phongdz98/Encoder/final_altium_encoder_project/step 3d file/encoder.step

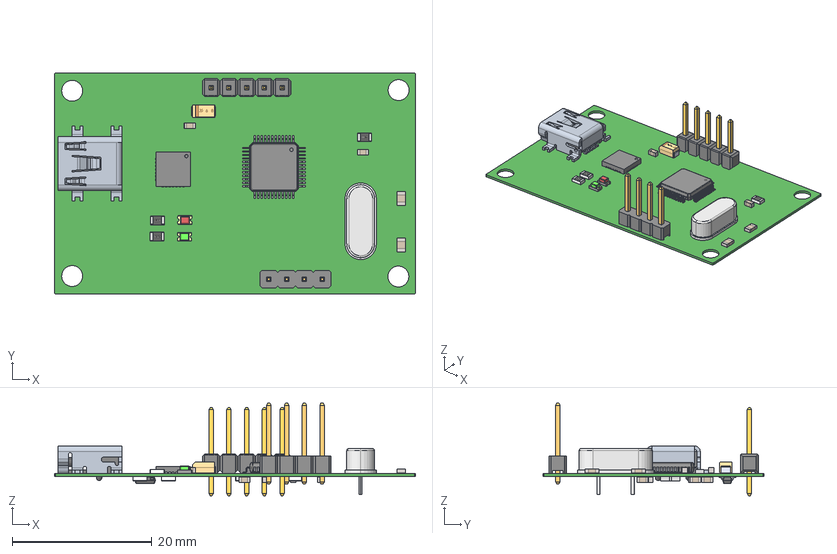
[picture p21: CAD file, 2021-06-27]
final_altium_encoder_project/step 3d file/encoder.step
51.7 x 31.6 x 13.3 mm
User_Library-SMD_RESISTOR-10805 x 7
CAP_TANT_3216-18
User_Library-USB_mini_B
Header_1x4
User_Library-User_Library-led_0805_GRE
User_Library-User_Library-led_0805_R
BODY_VBH48A
LEAD_VBH48A x 48
User_Library-sot143
User_Library-SMD_CAPACITOR0603 x 7
User_Library-SMD_CAPACITOR0805 x 2
