phongdz98/Encoder/final_altium_encoder_project/User Library-QFN28-0_5.STEP

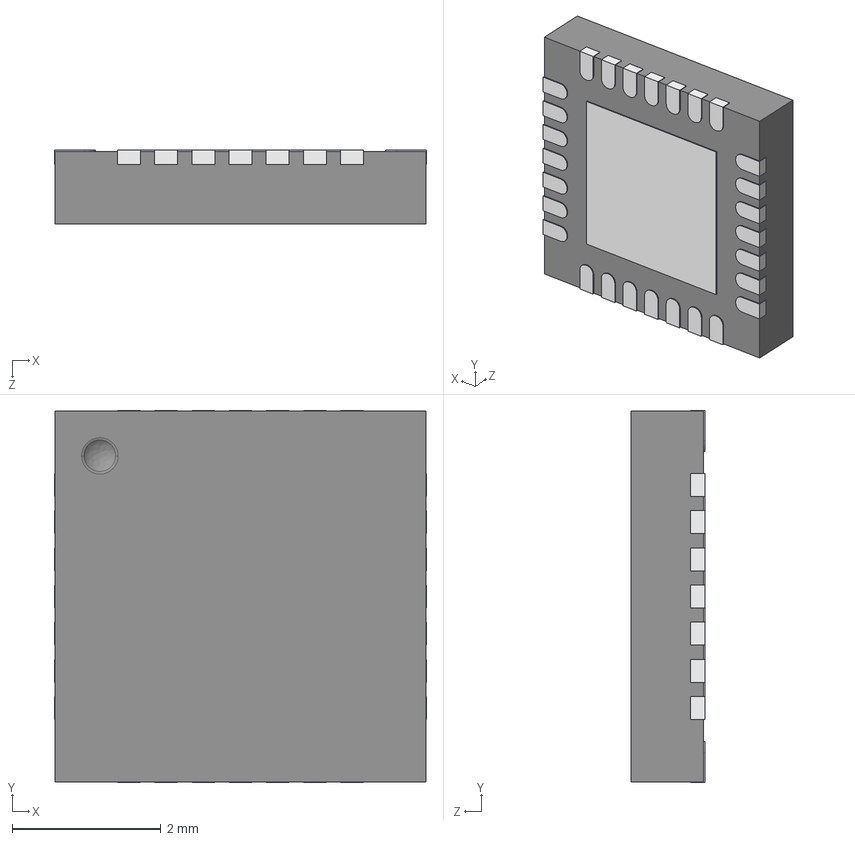
[picture p22: CAD file, 2021-06-27]
final_altium_encoder_project/User Library-QFN28-0_5.STEP
5.00 x 5.00 x 1.00 mm
