phongdz98/Encoder/(list of files, cad)

Other CAD files:
final_altium_encoder_project/step 3d file/BODY_VBH48A.ipt
final_altium_encoder_project/step 3d file/Board.iam
final_altium_encoder_project/step 3d file/C1.iam
final_altium_encoder_project/step 3d file/C10.iam
final_altium_encoder_project/step 3d file/C2.iam
final_altium_encoder_project/step 3d file/C3.iam
final_altium_encoder_project/step 3d file/C4.iam
final_altium_encoder_project/step 3d file/C5.iam
final_altium_encoder_project/step 3d file/C6.iam
final_altium_encoder_project/step 3d file/C7.iam
final_altium_encoder_project/step 3d file/C8.iam
final_altium_encoder_project/step 3d file/C9.iam
final_altium_encoder_project/step 3d file/CAP_TANT_3216-18.ipt
final_altium_encoder_project/step 3d file/DA1.iam
final_altium_encoder_project/step 3d file/DD1.iam
final_altium_encoder_project/step 3d file/DD2.iam
final_altium_encoder_project/step 3d file/Fillet.ipt
final_altium_encoder_project/step 3d file/Fillet002.ipt
final_altium_encoder_project/step 3d file/Fillet_1.ipt
final_altium_encoder_project/step 3d file/Fusion.ipt
final_altium_encoder_project/step 3d file/Fusion_1.ipt
final_altium_encoder_project/step 3d file/Header_1x4.ipt
final_altium_encoder_project/step 3d file/LEAD_VBH48A.ipt
final_altium_encoder_project/step 3d file/OldVersions/BODY_VBH48A.0001.ipt
final_altium_encoder_project/step 3d file/OldVersions/Board.0001.iam
final_altium_encoder_project/step 3d file/OldVersions/C1.0001.iam
final_altium_encoder_project/step 3d file/OldVersions/C10.0001.iam
final_altium_encoder_project/step 3d file/OldVersions/C2.0001.iam
final_altium_encoder_project/step 3d file/OldVersions/C3.0001.iam
final_altium_encoder_project/step 3d file/OldVersions/C4.0001.iam
final_altium_encoder_project/step 3d file/OldVersions/C5.0001.iam
final_altium_encoder_project/step 3d file/OldVersions/C6.0001.iam
final_altium_encoder_project/step 3d file/OldVersions/C7.0001.iam
final_altium_encoder_project/step 3d file/OldVersions/C8.0001.iam
final_altium_encoder_project/step 3d file/OldVersions/C9.0001.iam
final_altium_encoder_project/step 3d file/OldVersions/CAP_TANT_3216-18.0001.ipt
final_altium_encoder_project/step 3d file/OldVersions/DA1.0001.iam
final_altium_encoder_project/step 3d file/OldVersions/DD1.0001.iam
final_altium_encoder_project/step 3d file/OldVersions/DD2.0001.iam
final_altium_encoder_project/step 3d file/OldVersions/Fillet.0001.ipt
final_altium_encoder_project/step 3d file/OldVersions/Fillet002.0001.ipt
final_altium_encoder_project/step 3d file/OldVersions/Fillet_1.0001.ipt
final_altium_encoder_project/step 3d file/OldVersions/Fusion.0001.ipt
final_altium_encoder_project/step 3d file/OldVersions/Fusion_1.0001.ipt
final_altium_encoder_project/step 3d file/OldVersions/Header_1x4.0001.ipt
final_altium_encoder_project/step 3d file/OldVersions/LEAD_VBH48A.0001.ipt
final_altium_encoder_project/step 3d file/OldVersions/Open CASCADE STEP translator 6.8 1.1.1.0001.ipt
final_altium_encoder_project/step 3d file/OldVersions/Open CASCADE STEP translator 6.8 1.11.1.2.0001.ipt
final_altium_encoder_project/step 3d file/OldVersions/PT0048A.0001.iam
final_altium_encoder_project/step 3d file/OldVersions/Pin_Header_1x5_TH_Pitch_2.54mm.0001.iam
final_altium_encoder_project/step 3d file/OldVersions/Pin_Header_1x5_TH_Pitch_2.54mm.0002.iam
final_altium_encoder_project/step 3d file/OldVersions/R1.0001.iam
final_altium_encoder_project/step 3d file/OldVersions/R2.0001.iam
final_altium_encoder_project/step 3d file/OldVersions/R3.0001.iam
final_altium_encoder_project/step 3d file/OldVersions/R4.0001.iam
final_altium_encoder_project/step 3d file/OldVersions/R5.0001.iam
final_altium_encoder_project/step 3d file/OldVersions/R6.0001.iam
final_altium_encoder_project/step 3d file/OldVersions/R7.0001.iam
final_altium_encoder_project/step 3d file/OldVersions/User_Library-HC49S-1.0001.iam
final_altium_encoder_project/step 3d file/OldVersions/User_Library-QFN28-0_5.0001.iam
final_altium_encoder_project/step 3d file/OldVersions/User_Library-SMD_CAPACITOR0603.0001.ipt
final_altium_encoder_project/step 3d file/OldVersions/User_Library-SMD_CAPACITOR0805.0001.ipt
final_altium_encoder_project/step 3d file/OldVersions/User_Library-SMD_RESISTOR-10805.0001.ipt
final_altium_encoder_project/step 3d file/OldVersions/User_Library-USB_mini_B.0001.ipt
final_altium_encoder_project/step 3d file/OldVersions/User_Library-User_Library-led_0805_GRE.0001.ipt
final_altium_encoder_project/step 3d file/OldVersions/User_Library-User_Library-led_0805_R.0001.ipt
final_altium_encoder_project/step 3d file/OldVersions/User_Library-sot143.0001.ipt
final_altium_encoder_project/step 3d file/OldVersions/VD1.0001.iam
final_altium_encoder_project/step 3d file/OldVersions/VD2.0001.iam
final_altium_encoder_project/step 3d file/OldVersions/X1.0001.iam
final_altium_encoder_project/step 3d file/OldVersions/X2.0001.iam
final_altium_encoder_project/step 3d file/OldVersions/X3.0001.iam
final_altium_encoder_project/step 3d file/OldVersions/X3.0002.iam
final_altium_encoder_project/step 3d file/OldVersions/ZQ1.0001.iam
final_altium_encoder_project/step 3d file/OldVersions/encoder.0001.iam
final_altium_encoder_project/step 3d file/Open CASCADE STEP translator 6.8 1.1.1.ipt
final_altium_encoder_project/step 3d file/Open CASCADE STEP translator 6.8 1.11.1.1.ipt
final_altium_encoder_project/step 3d file/Open CASCADE STEP translator 6.8 1.11.1.2.ipt
final_altium_encoder_project/step 3d file/Open CASCADE STEP translator 6.8 1.11.1.3.ipt
final_altium_encoder_project/step 3d file/PT0048A.iam
final_altium_encoder_project/step 3d file/Pin_Header_1x5_TH_Pitch_2.54mm.iam
final_altium_encoder_project/step 3d file/R1.iam
final_altium_encoder_project/step 3d file/R2.iam
final_altium_encoder_project/step 3d file/R3.iam
final_altium_encoder_project/step 3d file/R4.iam
final_altium_encoder_project/step 3d file/R5.iam
final_altium_encoder_project/step 3d file/R6.iam
final_altium_encoder_project/step 3d file/R7.iam
final_altium_encoder_project/step 3d file/User_Library-HC49S-1.iam
final_altium_encoder_project/step 3d file/User_Library-QFN28-0_5.iam
final_altium_encoder_project/step 3d file/User_Library-SMD_CAPACITOR0603.ipt
final_altium_encoder_project/step 3d file/User_Library-SMD_CAPACITOR0805.ipt
final_altium_encoder_project/step 3d file/User_Library-SMD_RESISTOR-10805.ipt
final_altium_encoder_project/step 3d file/User_Library-USB_mini_B.ipt
final_altium_encoder_project/step 3d file/User_Library-User_Library-led_0805_GRE.ipt
final_altium_encoder_project/step 3d file/User_Library-User_Library-led_0805_R.ipt
final_altium_encoder_project/step 3d file/User_Library-sot143.ipt
final_altium_encoder_project/step 3d file/VD1.iam
final_altium_encoder_project/step 3d file/VD2.iam
final_altium_encoder_project/step 3d file/X1.iam
final_altium_encoder_project/step 3d file/X2.iam
final_altium_encoder_project/step 3d file/X3.iam
final_altium_encoder_project/step 3d file/ZQ1.iam
final_altium_encoder_project/step 3d file/encoder.iam
