phongdz98/Encoder/final-document/ПД2.pdf

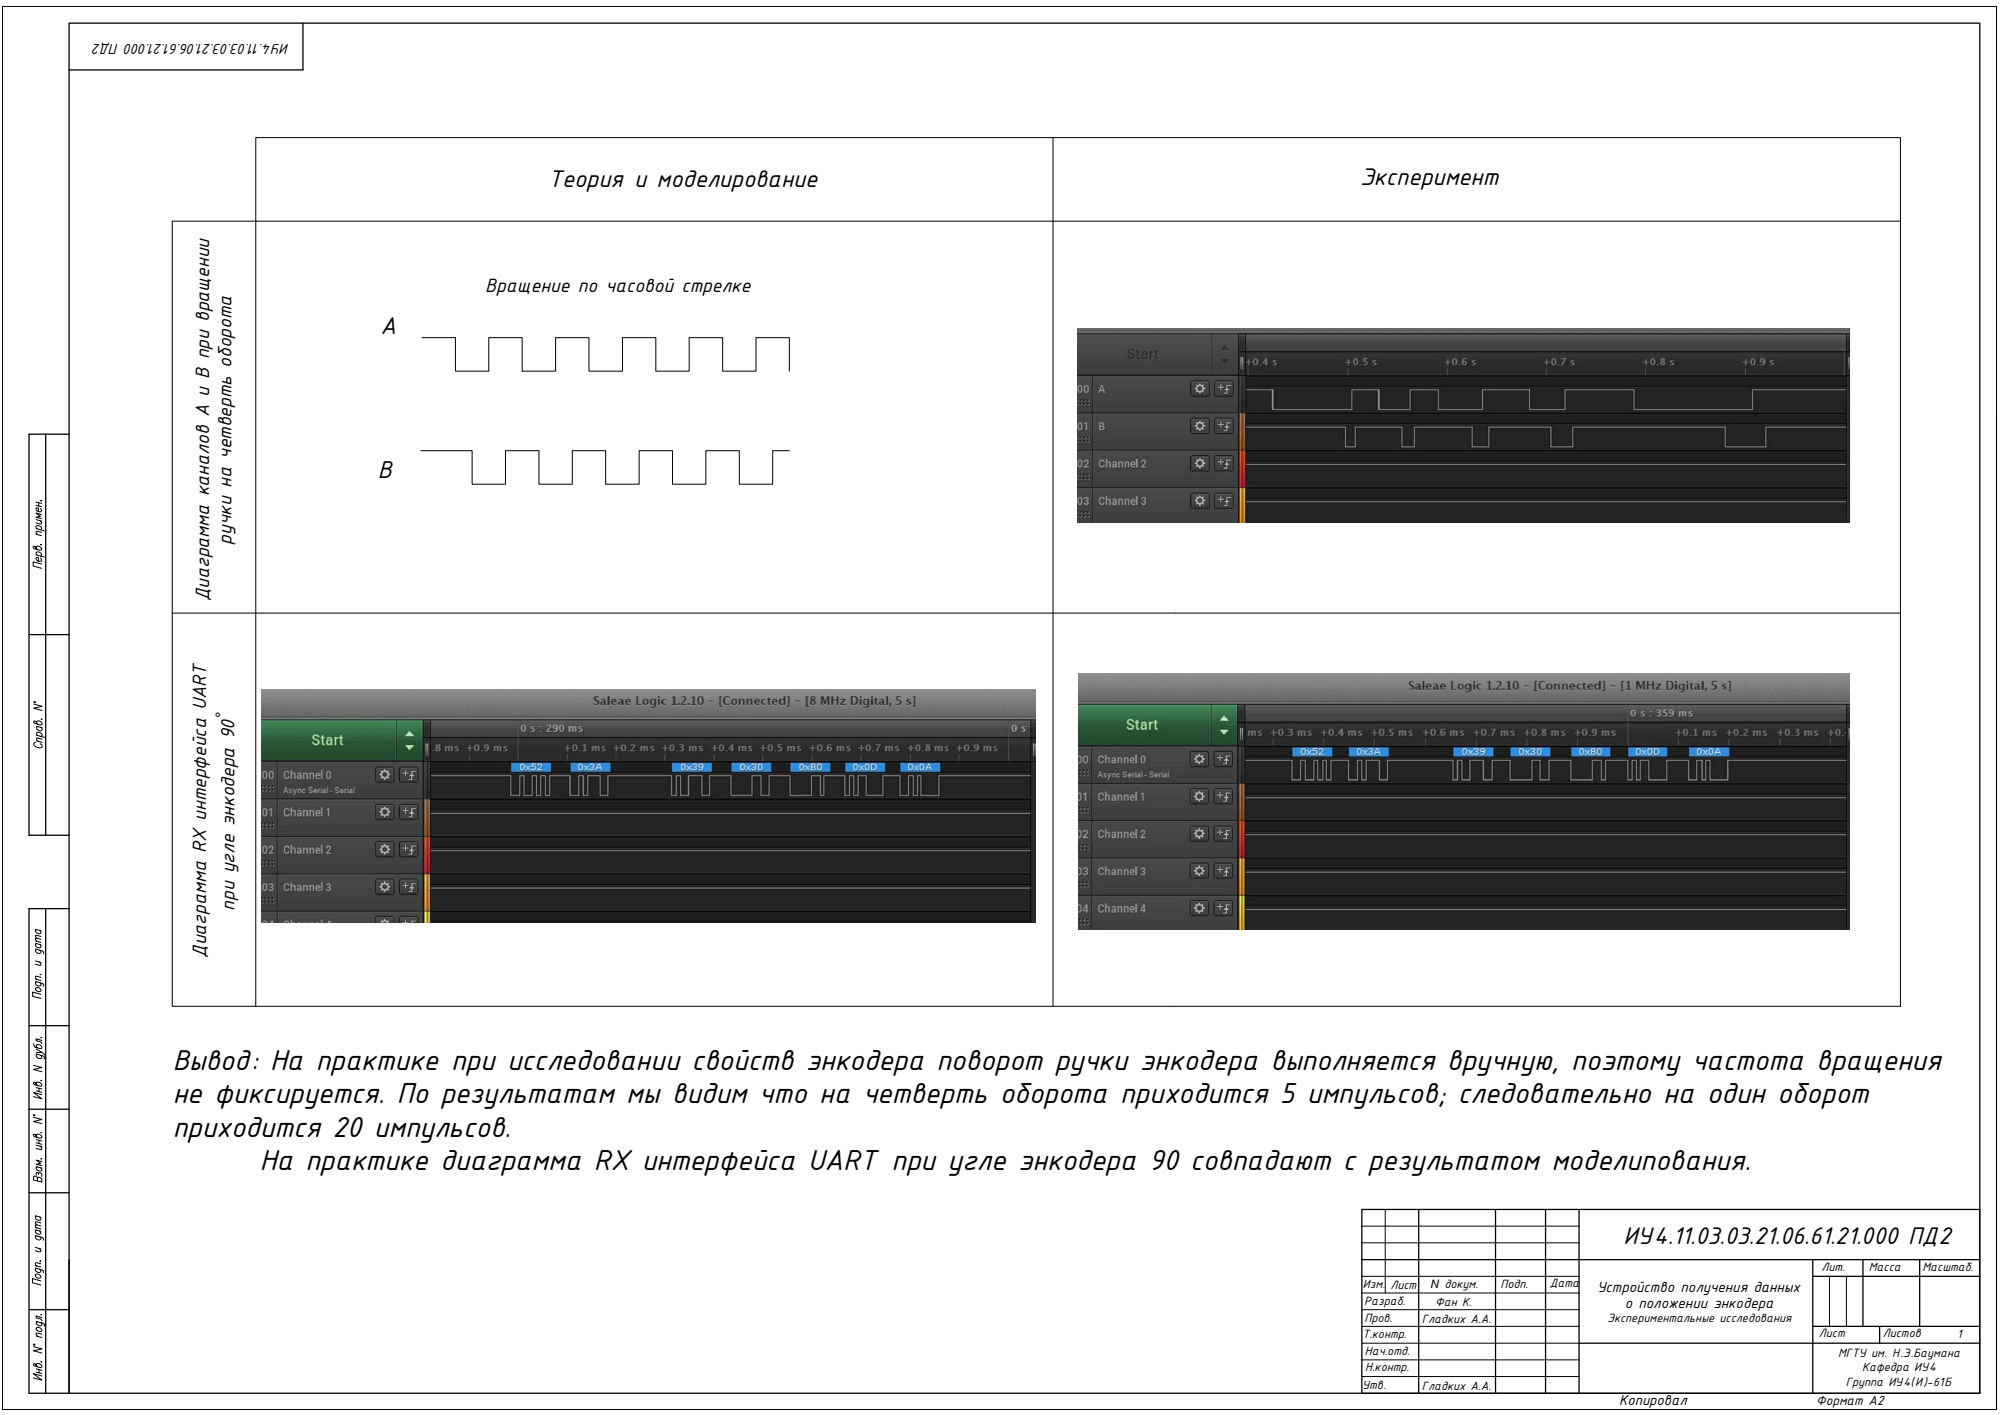
[picture p24: page 1]
Копировал; Формат А2

Теория и моделирование | Эксперимент

Диаграмма каналов А и В при вращении

Вращение по часовой стрелке А

ручки на четверть оборота

Диаграмма RX интерфейса UART при угле энкодера 90˚

Вывод: На практике при исследовании свойств энкодера поворот ручки энкодера выполняется вручную, поэтому частота вращения
не фиксируется. По результатам мы видим что на четверть оборота приходится 5 импульсов; следовательно на один оборот
приходится 20 импульсов.

На практике диаграмма RX интерфейса UART при угле энкодера 90 совпадают с результатом моделипования.

Устройство получения данных о положении энкодера Экспериментальные исследования | Лит. | Масса | Масштаб.

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
