phongdz98/Encoder/final-document/ПД3.pdf

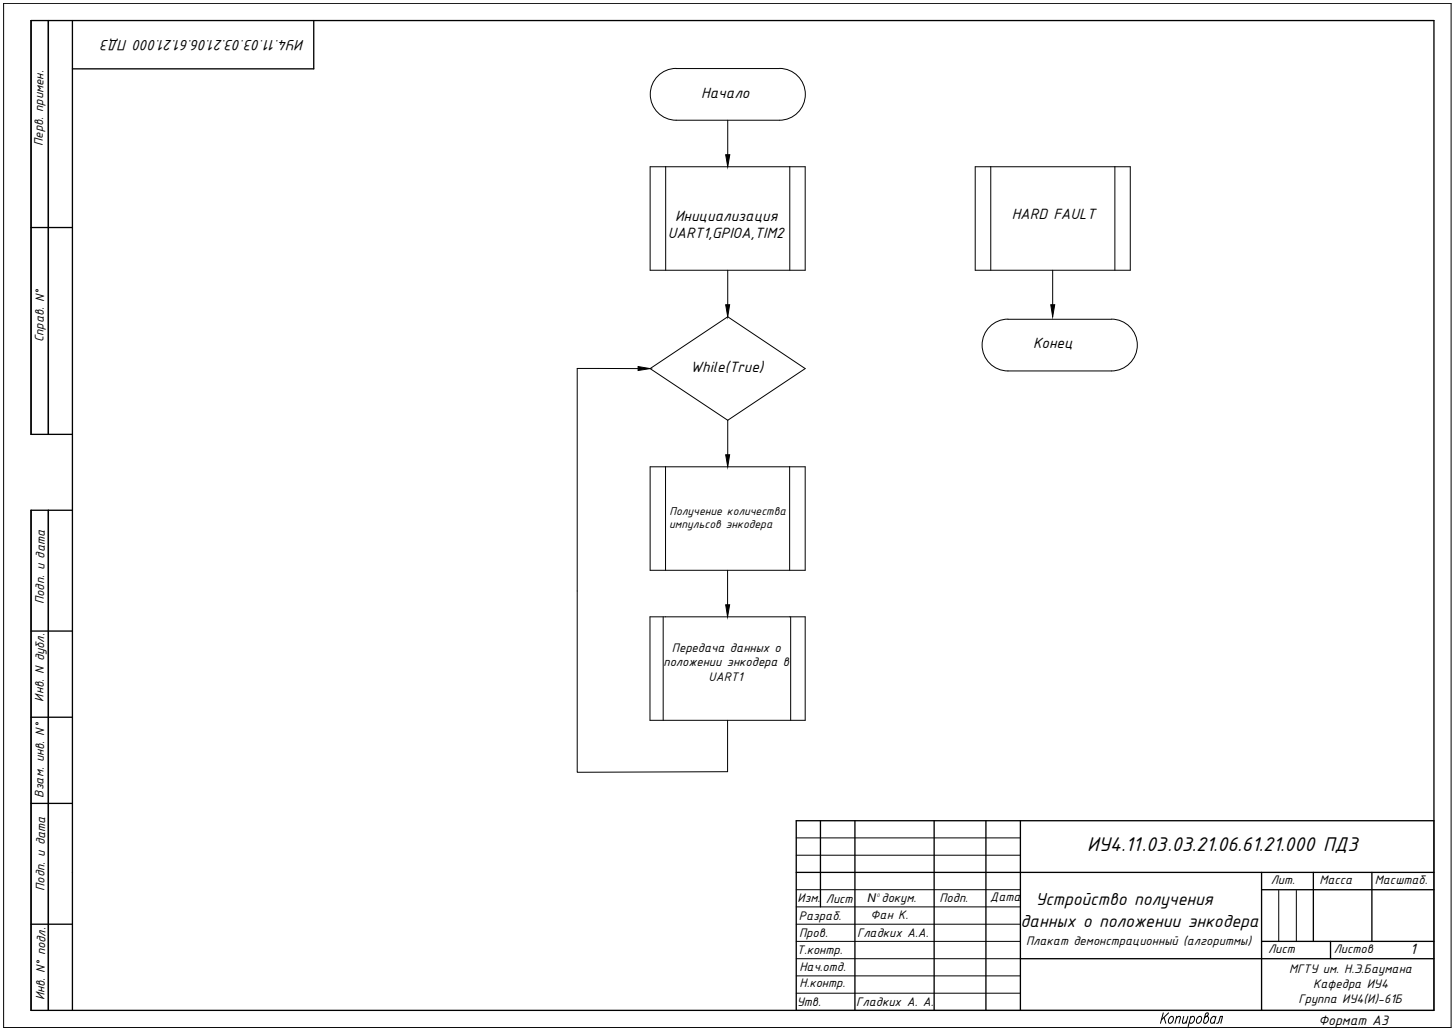
[picture p25: page 1]
Формат А3; Получение количества импульсов энкодера; Передача; данных о; положении; энкодера в; HARD FAULT

Перв. примен. Справ. N° Подп. и дата Инв. N дубл. Взам. инв. N° Подп. и дата Инв. N° подл.

Устройство получения данных о положении энкодера Плакат демонстрационный (алгоритмы) | Лит. | Масса | Масштаб.

Изм. | Лист | N докум. О | Подп. | Дата
Разраб. | | Фан К.
Пров. | | Гладких А.А.
Т.контр. | | | | | Лист | Листов 1
Нач.отд. | | | | | МГТУ им. Н.Э.Баумана Кафедра ИУ4 Группа ИУ4(И)-61Б
Н.контр.
Утв. | Гладких А. А.
