phongdz98/Encoder/final-document/ПП.pdf

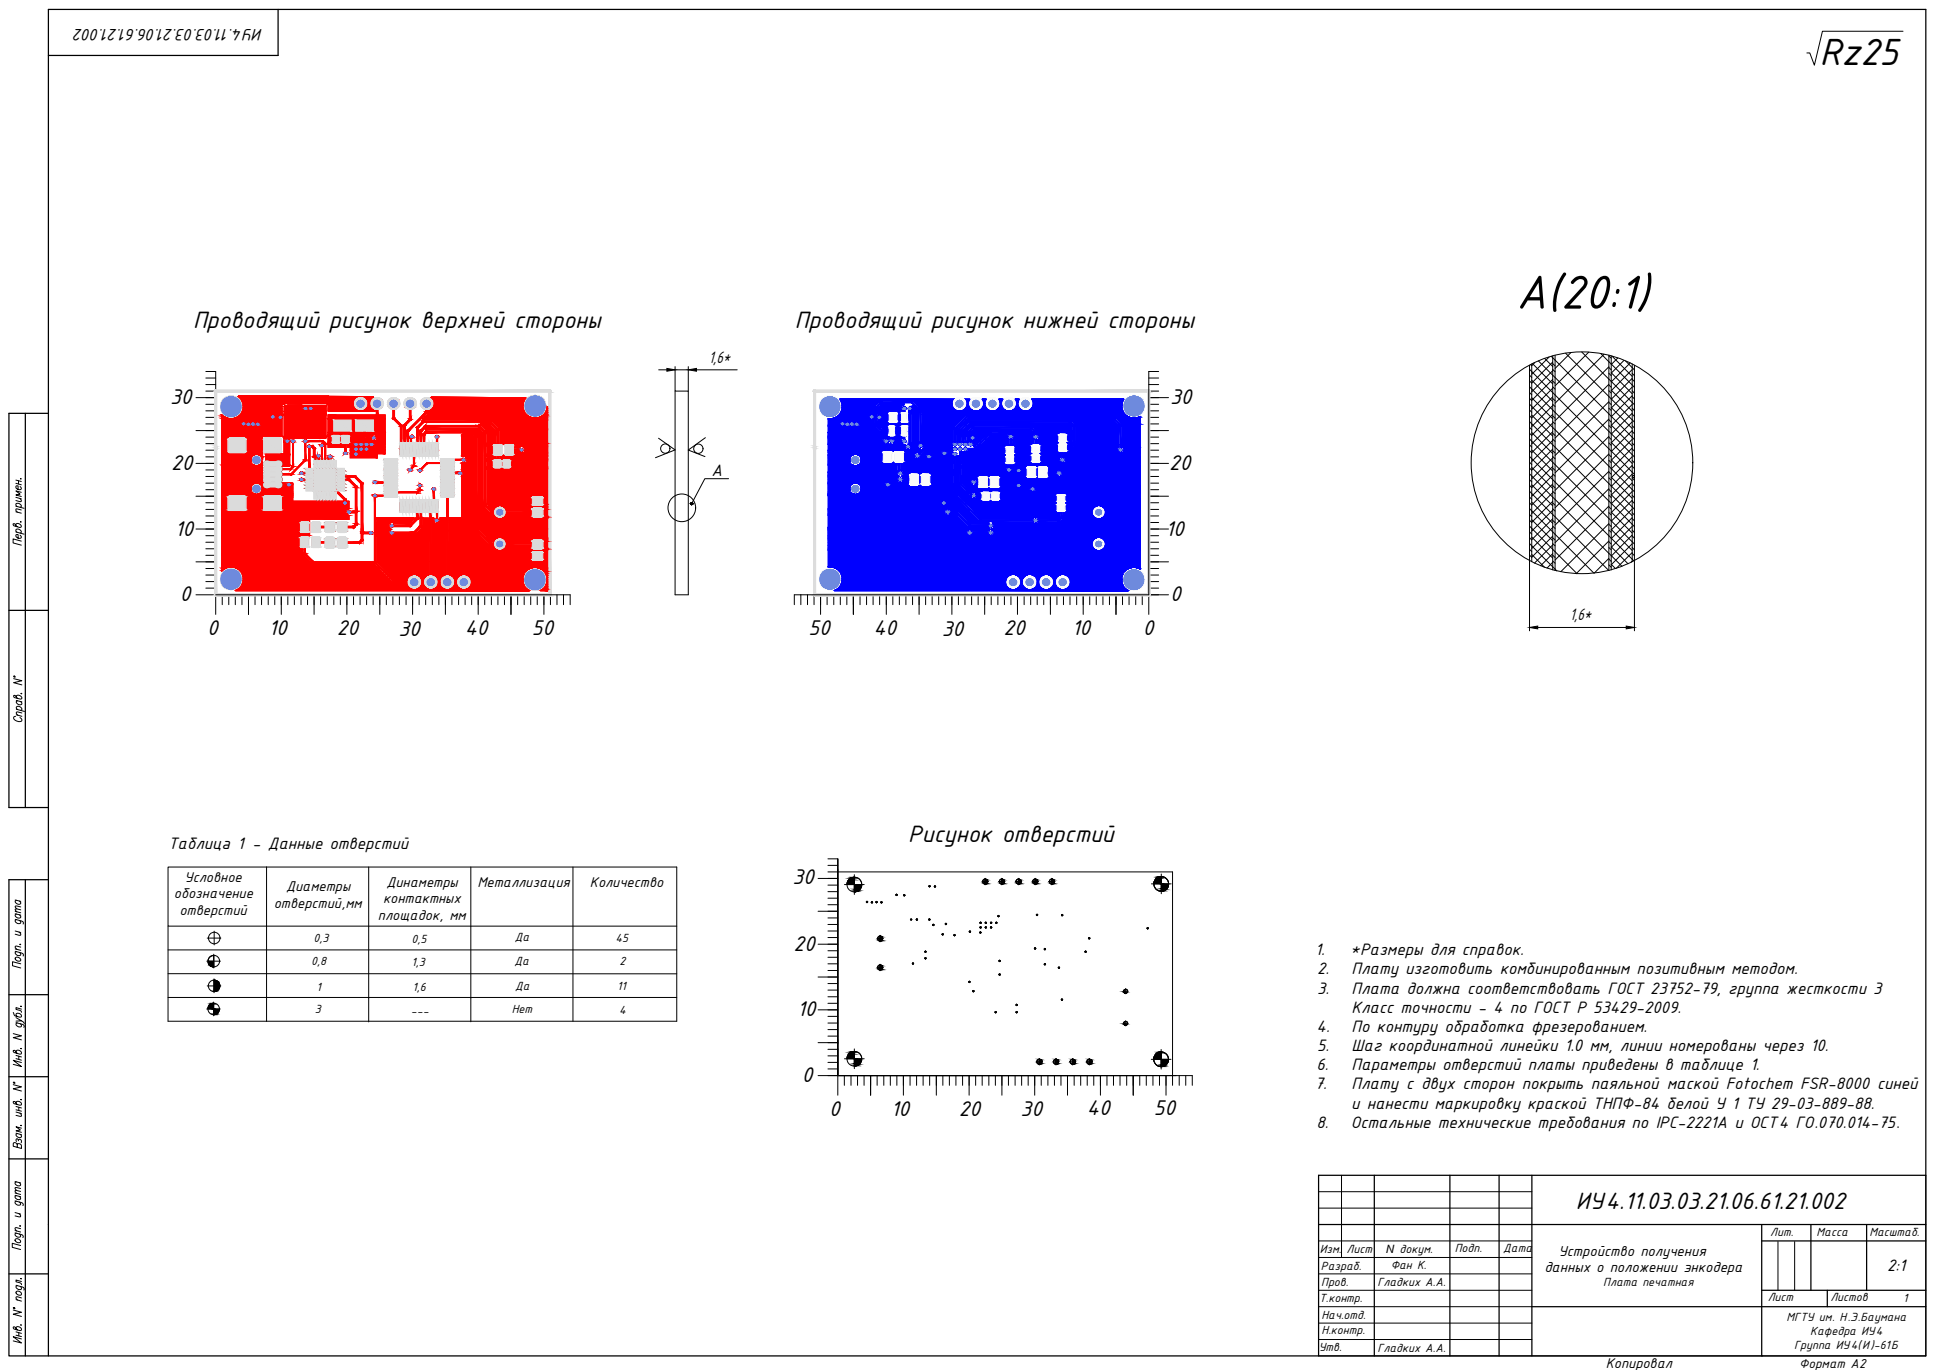
[picture p26: page 1]
Копировал; Формат А2; Рисунок отверстий

Проводящий рисунок верхней стороны

Проводящий рисунок нижней стороны

Таблицa 1 - Данные отверстий

Условное
обозначение отверстий | Диаметры отверстий,мм | Динаметры контактных площадок, мм | Металлизация | Количество | и нанести маркировку краской ТНПФ-84 белой У 1 ТУ 29-03-889-88. 8. Остальные технические требования по IPC-2221A и ОСТ4 ГО.070.014-75.

1. *Размеры для справок.
2. Плату изготовить комбинированным позитивным методом.
3. Плата должна соответствовать ГОСТ 23752-79, группа жесткости 3
Класс точности - 4 по ГОСТ Р 53429-2009.
4. По контуру обработка фрезерованием.
5. Шаг координатной линейки 1.0 мм, линии номерованы через 10.
6. Параметры отверстий платы приведены в таблице 1.
7. Плату с двух сторон покрыть паяльной маской Fotochem FSR-8000 синей

3 | --- | Нет | 4

Устройство получения данных о положении энкодера Плата печатная | Лит. | Масса | Масштаб.

Изм. | Лист | N докум. | Подп. | Дата | | | | | 2:1
Разраб. | | Фан К.
Пров. | | Гладких А.А.
Т.контр. | | | | | Лист | Листов 1
Нач.отд. | | | | | МГТУ им. Н.Э.Баумана Кафедра ИУ4 Группа ИУ4(И)-61Б
Н.контр.
Утв. | Гладких А.А.
