phongdz98/Encoder/final-document/ПЭ3.pdf

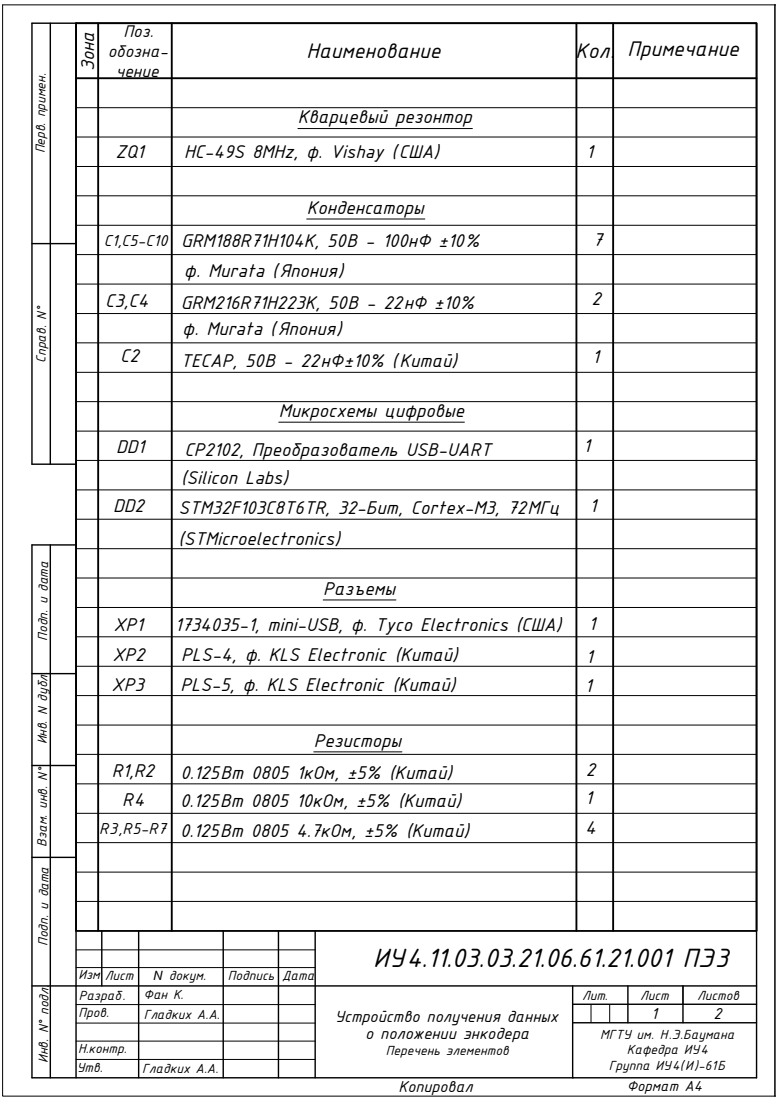
[picture p27: page 1]
Поз. обозна-; Наименование; Кол. Примечание Зона; Разраб. Изм; Лист; Копировал; Формат А4 Подп. и дата Инв. N дубл. Взам. инв. N° Подп. и дата Инв. N° подл. Перв. примен. Справ. N°

Кварцевый резонтор

ZQ1 | HC-49S 8MHz, ф. Vishay (США) | 1

Конденсаторы

C1,C5-C10 | GRM188R71H104K, 50В - 100нФ ±10% | 7

ф. Murata (Япония)

C3,C4 | GRM216R71H223K, 50В - 22нФ ±10% | 2

C2 | TECAP, 50В - 22нФ±10% (Китай) | 1

Микросхемы цифровые

DD1 | CP2102, Преобразователь USB-UART | 1

(Silicon Labs)

DD2 | STM32F103C8T6TR, 32-Бит, Cortex-M3, 72МГц | 1

(STMicroelectronics)

Разъемы

XP1 | 1734035-1, mini-USB, ф. Tyco Electronics (США) | 1
XP2 | PLS-4, ф. KLS Electronic (Китай) | 1
XP3 | PLS-5, ф. KLS Electronic (Китай) | 1

Резисторы

R1,R2 | 0.125Вт 0805 1кОм, ±5% (Китай) | 2
R4 | 0.125Вт 0805 10кОм, ±5% (Китай) | 1
R3 | 0.125Вт 0805 4.7кОм, ±5% (Китай) ,R5-R7 | 4

N докум. | Подпись | Дата
Фан К. | | Устройство получения данных о положении энкодера Перечень элементов | Лит. | Лист | Листов

Пров. | Гладких А.А. | | | | | | 1 | 2

МГТУ им. Н.Э.Баумана
Кафедра ИУ4
Группа ИУ4(И)-61Б

Н.контр.
Утв. | Гладких А.А.

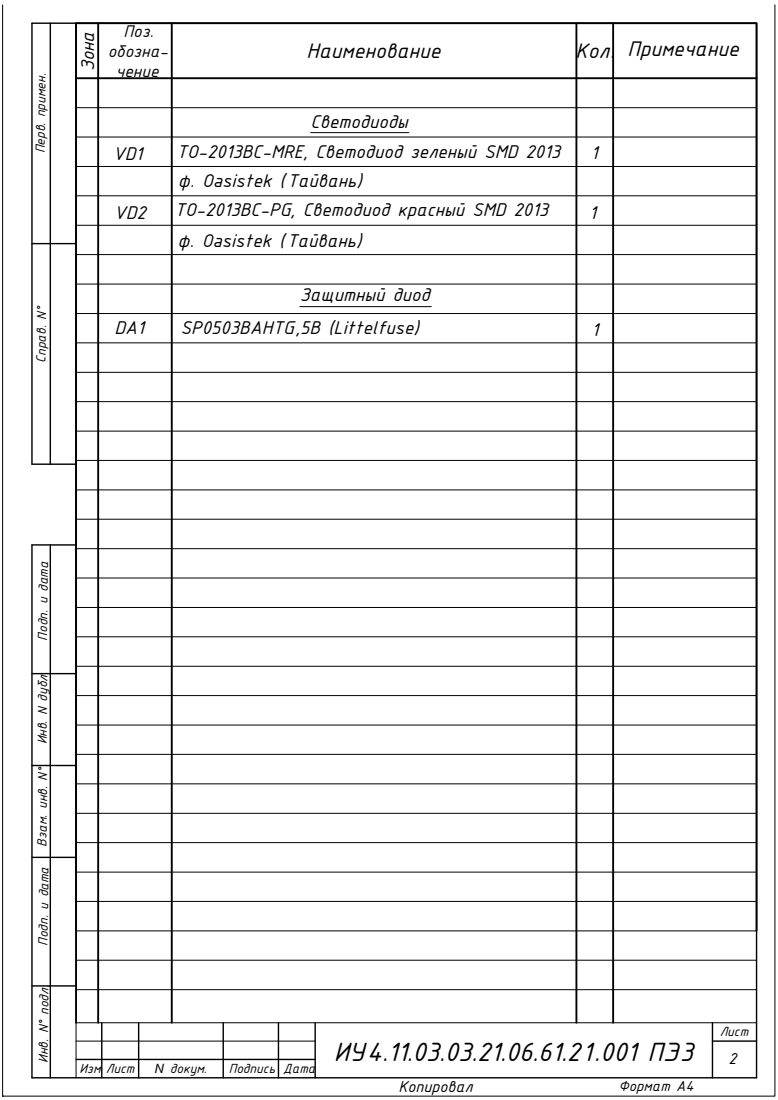
[picture p28: page 2]
Поз. обозна-; Наименование; Кол. Примечание Зона; Копировал; Формат А4 Подп. и дата Инв. N дубл. Взам. инв. N° Подп. и дата Инв. N° подл. Перв. примен. Справ. N°

Светодиоды

VD1 | TO-2013BC-MRE, Светодиод зеленый SMD 2013 | 1

ф. Oasistek (Тайвань)

VD2 | TO-2013BC-PG, Светодиод красный SMD 2013 | 1

Защитный диод

DA1 | SP0503BAHTG,5В (Littelfuse) | 1

Изм | Лист | N докум. | Подпись | Дата
