phongdz98/Encoder/final-document/СБ.pdf

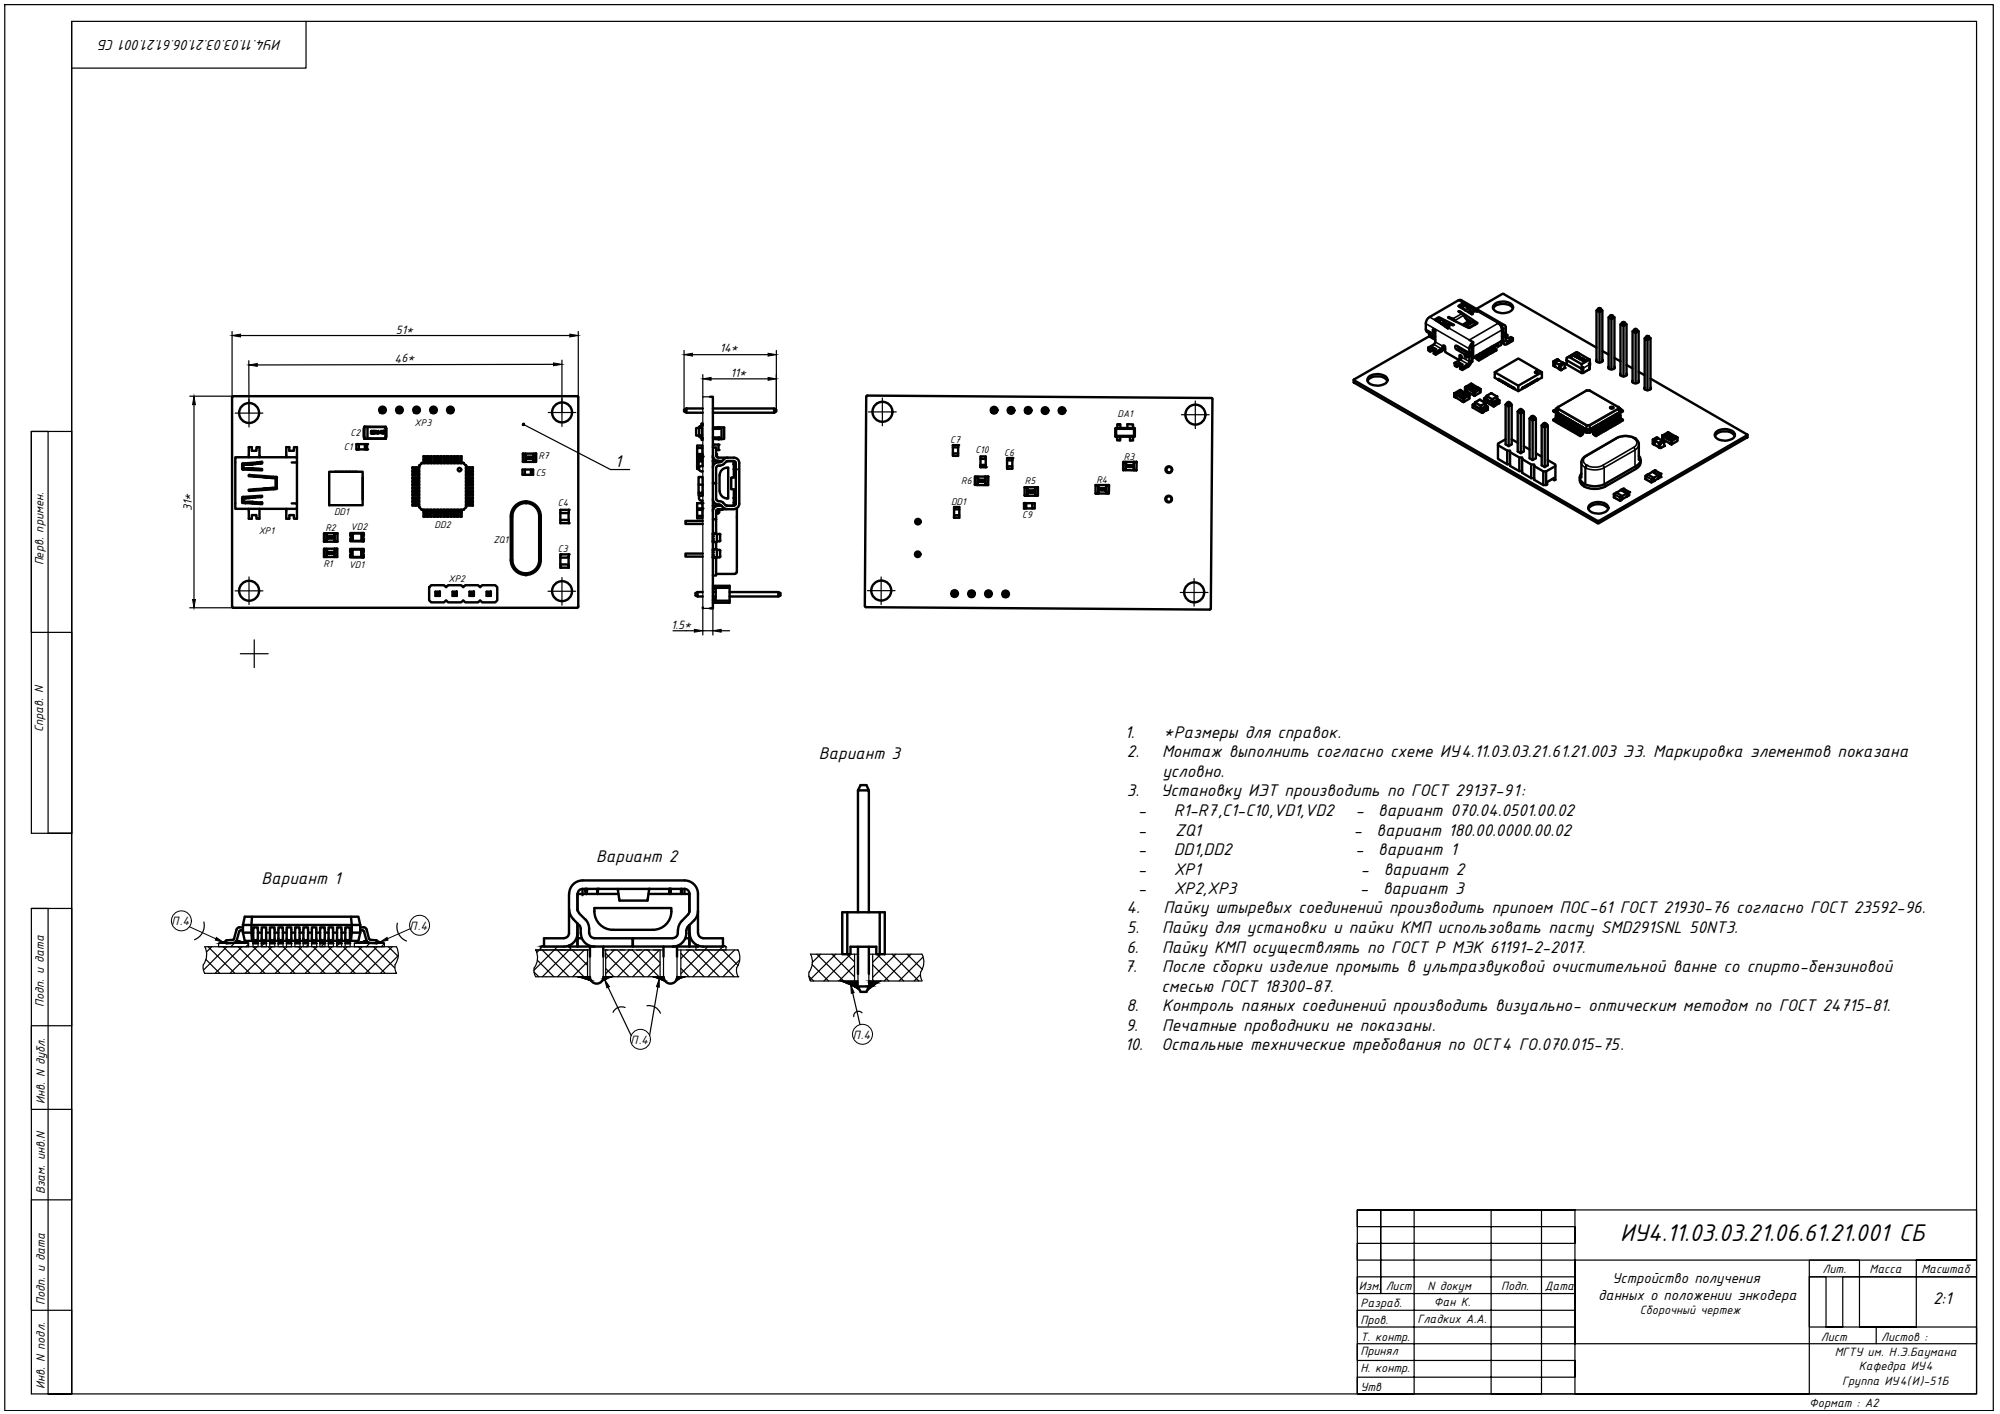
[picture p29: page 1]

Инв. N подл. Подп. и дата Взам. инв.N Подп. и дата Инв. N дубл. Справ. N Перв. примен.

4. Пайку штыревых соединений производить припоем ПОС-61 ГОСТ 21930-76 согласно ГОСТ 23592-96.
5. Пайку для установки и пайки КМП использовать пасту SMD291SNL 50NT3.
6. Пайку КМП осуществлять по ГОСТ Р МЭК 61191-2-2017.
7. После сборки изделие промыть в ультразвуковой очистительной ванне со спирто-бензиновой
смесью ГОСТ 18300-87.
8. Контроль паяных соединений производить визуально- оптическим методом по ГОСТ 24715-81.

Устройство получения данных о положении энкодера | Лит. | Масса | Масштаб

Изм. | Лист | N докум | Подп. | Дата | | | | | 2:1
Разраб. | | | | | Сборочный чертеж Фан К.
Пров. | | Гладких А.А.
Т. контр. | | | | | Лист | Листов :
Принял | | | | | МГТУ им. Н.Э.Баумана Кафедра ИУ4 Группа ИУ4(И)-51Б
Н. контр.
Утв
