phongdz98/Encoder/final-document/СП.pdf

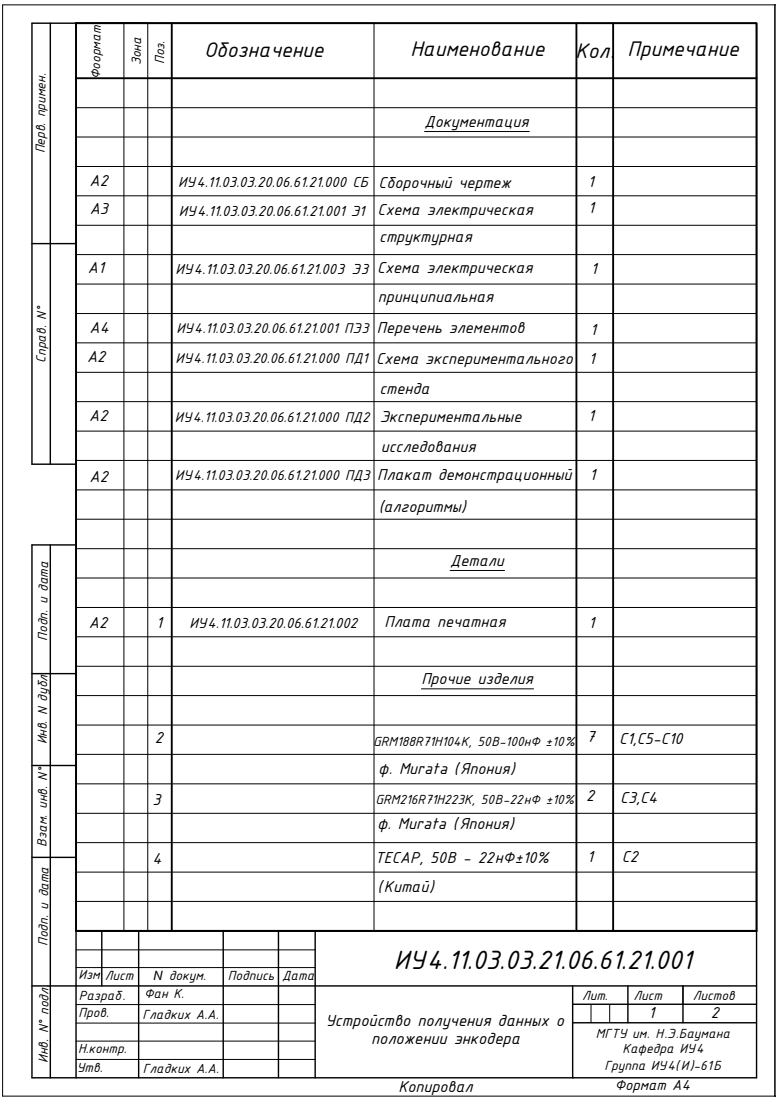
[picture p30: page 1]
Наименование; Кол. Примечание; Разраб. Изм; Лист; Копировал; Формат А4 Подп. и дата Инв. N дубл. Взам. инв. N° Подп. и дата Инв. N° подл. Перв. примен. Справ. N°; Прочие изделия; Плата печатная

Зона | Поз. 1 Фоормат | Обозначение | структурная

A2 | | | ИУ4.11.03.03.20.06.61.21.000 СБ | Сборочный чертеж | 1
A3 | | | ИУ4.11.03.03.20.06.61.21.001 Э1 | Схема электрическая | 1

A1 | | | ИУ4.11.03.03.20.06.61.21.003 Э3 | Схема электрическая | 1

принципиальная

A4 | | | ИУ4.11.03.03.20.06.61.21.001 ПЭ3 | Перечень элементов | 1

A2 | | | ИУ4.11.03.03.20.06.61.21.000 ПД1 | Схема экспериментального | 1

стенда

A2 | | | ИУ4.11.03.03.20.06.61.21.000 ПД2 | Экспериментальные | 1

исследования

A2 | | | ИУ4.11.03.03.20.06.61.21.000 ПД3 | Плакат демонстрационный | 1

(алгоритмы)

2 | GRM188R71H104K, 50В-100нФ ±10% | 7 | C1,C5-C10

ф. Murata (Япония)

3 | GRM216R71H223K, 50В-22нФ ±10% | 2 | C3,C4

4 | TECAP, 50В - 22нФ±10% | 1 | C2

(Китай)

N докум. | Подпись | Дата
Фан К. | | Устройство получения данных о положении энкодера | Лит. | Лист | Листов

Пров. | Гладких А.А. | | | | | | 1 | 2

МГТУ им. Н.Э.Баумана
Кафедра ИУ4
Группа ИУ4(И)-61Б

Н.контр.
Утв. | Гладких А.А.

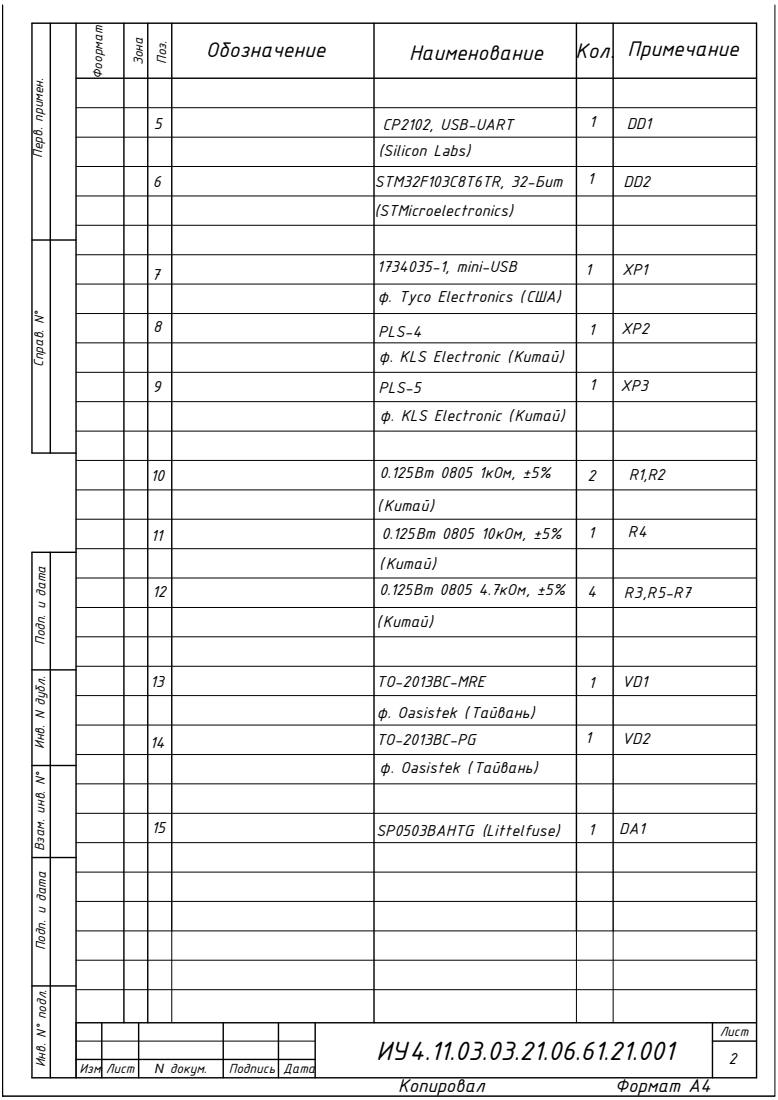
[picture p31: page 2]
Копировал; Формат А4; Наименование; Кол. Примечание Подп. и дата Инв. N дубл. Взам. инв. N° Подп. и дата Инв. N° подл. Перв. примен. Справ. N°; Изм; Лист; N докум.; Подпись; Дата; SP0503BAHTG (Littelfuse)

Фоормат Зона Поз. Обозначение

5 | CP2102, USB-UART | 1 | DD1

(Silicon Labs)

6 | STM32F103C8T6TR, 32-Бит | 1 | DD2

(STMicroelectronics)

7 | 1734035-1, mini-USB | 1 | XP1

ф. Tyco Electronics ( США)

8 | PLS-4 | 1 | XP2

ф. KLS Electronic (Китай)

9 | PLS-5 | 1 | XP3

10 | 0.125Вт 0805 1кОм, ±5% | 2 | R1,R2

(Китай)

11 | 0.125Вт 0805 10кОм, ±5% | 1 | R4

12 | 0.125Вт 0805 4.7кОм, ±5% | 4 | R3,R5-R7

13 | TO-2013BC-MRE | 1 | VD1

ф. Oasistek (Тайвань)
