phongdz98/Encoder/final-document/Э3.pdf

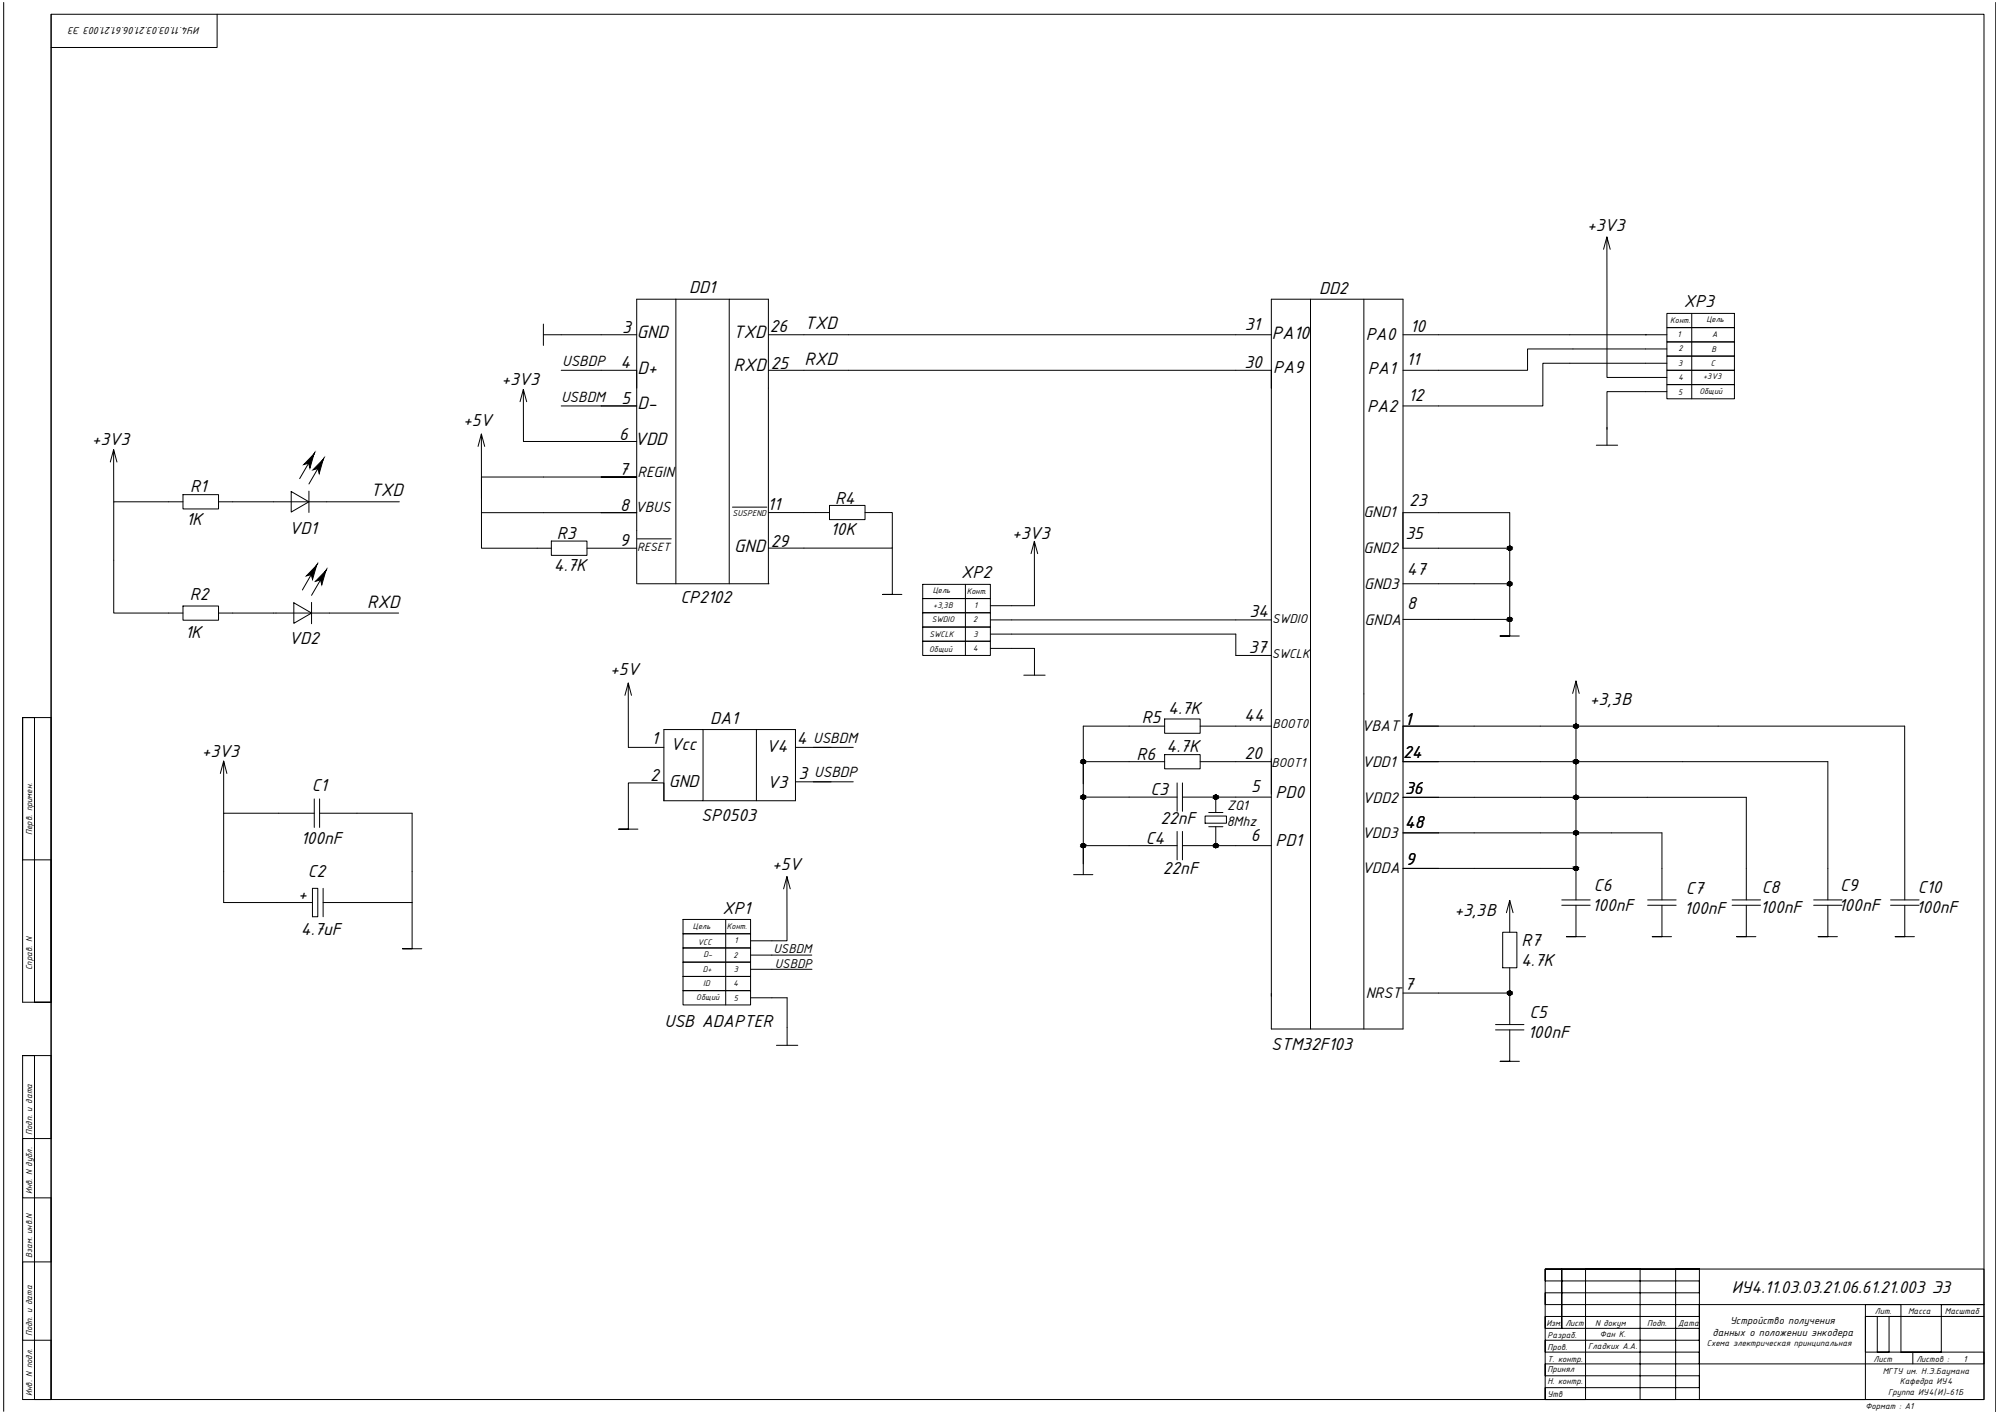
[picture p32: page 1]

Конт. | Цель

R4 | SWDIO 34 | 12 | 4 | +3V3

5 | Общий

SWDIO | 2

SWCLK | 3
Общий | 4

4.7uF Инв. N подл. Подп. и дата Взам. инв.N Подп. и дата Инв. N дубл. Справ. N Перв. примен.

Цель | Конт.

VCC | 1
D- | 2

D+ | 3
ID | 4
Общий | 5

7 NRST

Устройство получения данных о положении энкодера Схема электрическая принципальная | Лит. | Масса | Масштаб

Изм. | Лист | N докум | Подп. | Дата
Разраб. | | Фан К.
Пров. | | Гладких А.А.
Т. контр. | | | | | Лист | Листов : 1
Принял | | | | | МГТУ им. Н.Э.Баумана Кафедра ИУ4 Группа ИУ4(И)-61Б
Н. контр.
Утв
