phongdz98/Encoder/(list of files, drawings)

Other design files:
final_altium_encoder_project/encoder.PcbDoc
final_altium_encoder_project/encoder.PcbLib
final_altium_encoder_project/encoder.SchDoc
final_altium_encoder_project/encoder.SchLib
final_altium_encoder_project/encoder_project.PrjPcb
final_altium_encoder_project/encoder_schlib.SchLib
