phongdz98/Encoder/final_code/kur_encoder/Core/Src/main.c

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
/* Includes ------------------------------------------------------------------*/
#include "main.h"

/* USER CODE BEGIN Includes */
#include <stdio.h>
/* USER CODE END Includes */

/* USER CODE BEGIN PTD */
short tim_val;
/* USER CODE END PTD */

TIM_HandleTypeDef htim2;

UART_HandleTypeDef huart1;

void SystemClock_Config(void);
static void MX_GPIO_Init(void);
static void MX_TIM2_Init(void);
static void MX_USART1_UART_Init(void);
/* USER CODE BEGIN 0 */
_ARMABI int fputc(int c, FILE * stream)
{
	HAL_UART_Transmit(&huart1,(uint8_t*)&c,1,100);
	return 0;
}
/* USER CODE END 0 */

/**
  * @brief  The application entry point.
  * @retval int
  */
int main(void)
{
  /* USER CODE BEGIN 1 */
  volatile short encoder_cnt = 0;
  /* USER CODE END 1 */

  /* MCU Configuration--------------------------------------------------------*/

  /* Reset of all peripherals, Initializes the Flash interface and the Systick. */
  HAL_Init();

  /* Configure the system clock */
  SystemClock_Config();

  /* Initialize all configured peripherals */
  MX_GPIO_Init();
  MX_TIM2_Init();
  MX_USART1_UART_Init();
  /* USER CODE BEGIN 2 */
   HAL_TIM_Encoder_Start(&htim2, TIM_CHANNEL_1 | TIM_CHANNEL_2);
  /* USER CODE END 2 */

  /* Infinite loop */
  /* USER CODE BEGIN WHILE */
  while (1)
  {
    /* USER CODE END WHILE */

    /* USER CODE BEGIN 3 */
		tim_val = (__HAL_TIM_GET_COUNTER(&htim2))>>2   ;
		encoder_cnt = tim_val*360/20 ;
		if(HAL_GPIO_ReadPin(GPIOA,GPIO_PIN_2)==1)
   { 
		 
		 printf("R:%d°\r\n",encoder_cnt);
	 }
		 
		else
   {    
		   
     	 printf("P:%d°\r\n",encoder_cnt);
	 }
	 
		HAL_Delay(500);
  }
  /* USER CODE END 3 */
}

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
